djgene01/night-owl-radio/enclosure/ClockRadio_Foot_TPU_print4.stl

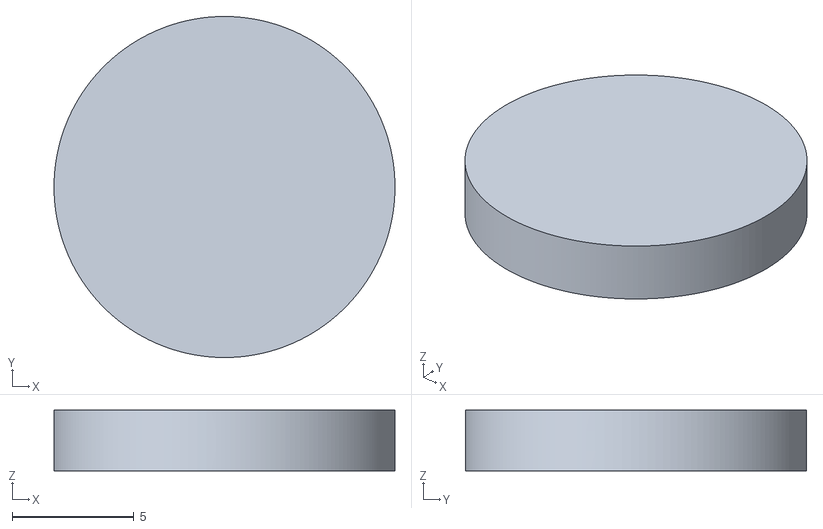
[picture p1: CAD file, 2026-11-01]
enclosure/ClockRadio_Foot_TPU_print4.stl
14.0 x 14.0 x 2.50
