djgene01/night-owl-radio/enclosure/ClockRadio_SpeakerStrap_print2.stl

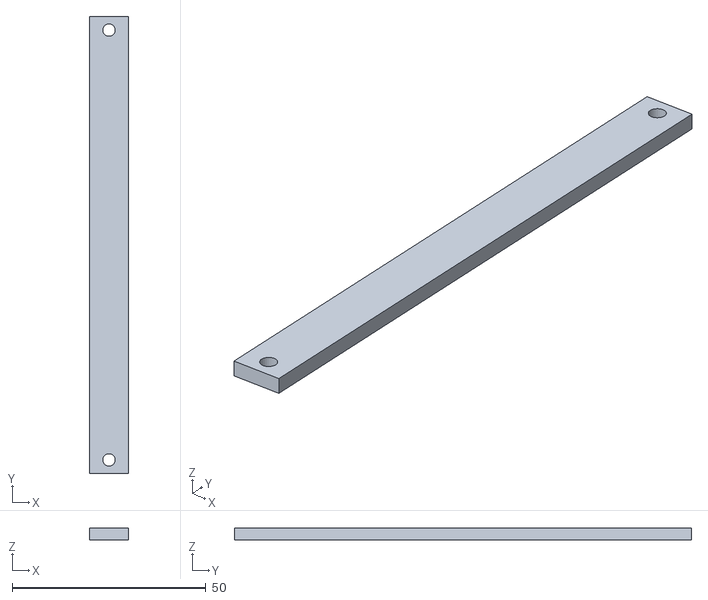
[picture p2: CAD file, 2026-11-01]
enclosure/ClockRadio_SpeakerStrap_print2.stl
10.0 x 118.0 x 3.00
