djgene01/night-owl-radio/enclosure/ClockRadio_BasePlate.stl

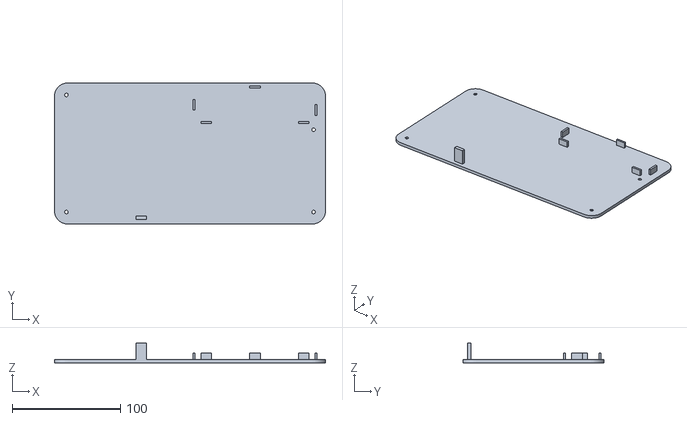
[picture p3: CAD file, 2026-11-01]
enclosure/ClockRadio_BasePlate.stl
250.0 x 130.0 x 18.0
