djgene01/night-owl-radio/enclosure/ClockRadio_Lens.stl

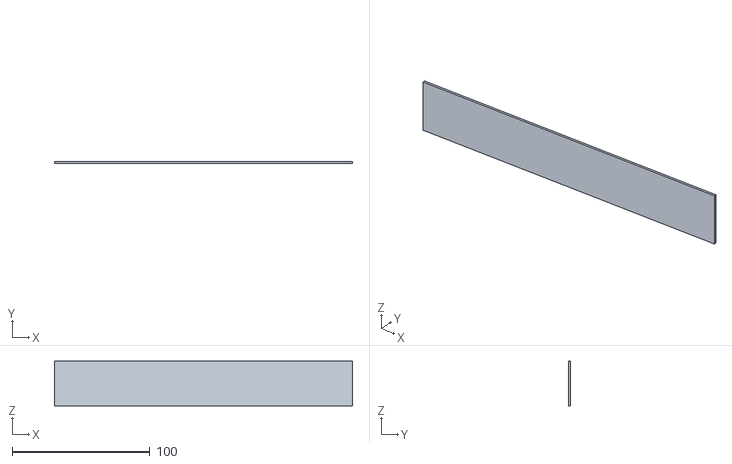
[picture p4: CAD file, 2026-11-01]
enclosure/ClockRadio_Lens.stl
216.0 x 1.50 x 32.5
