djgene01/night-owl-radio/enclosure/ClockRadio_Dial.stl

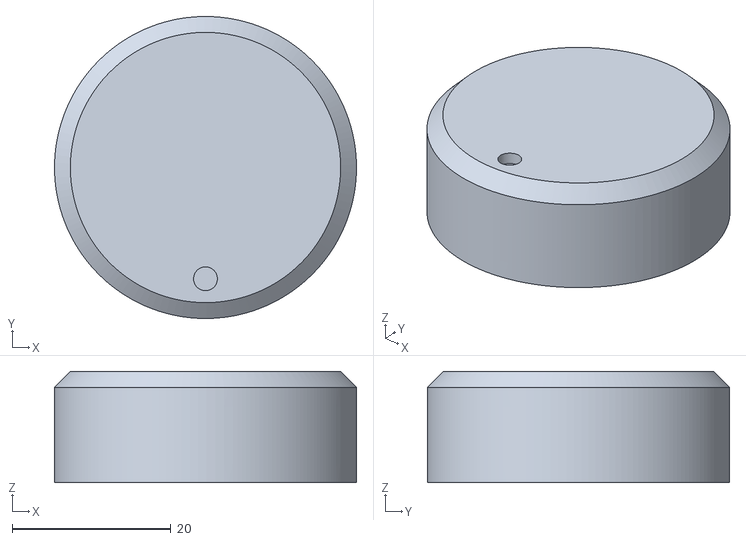
[picture p5: CAD file, 2026-11-01]
enclosure/ClockRadio_Dial.stl
38.0 x 38.0 x 14.0
