djgene01/night-owl-radio/enclosure/ClockRadio_Housing.stl

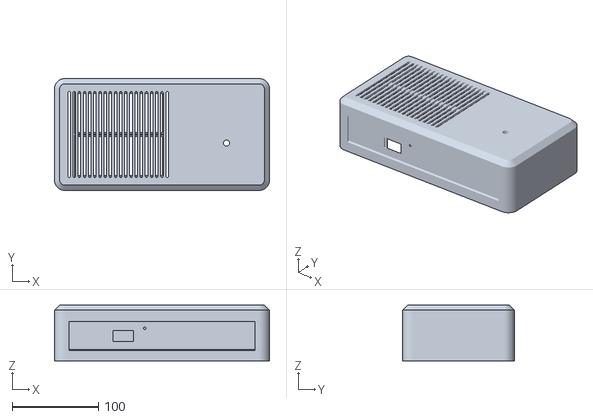
[picture p6: CAD file, 2026-11-01]
enclosure/ClockRadio_Housing.stl
250.0 x 130.0 x 65.0
