djgene01/night-owl-radio/firmware/RadioOLED/secrets.example.h

// Copy this file to secrets.h (same folder) and put your WiFi details in it.
// secrets.h is listed in .gitignore so your password never ends up on GitHub.
// The ESP32 only joins 2.4 GHz networks.
#pragma once
#define WIFI_SSID     "your-wifi-name"
#define WIFI_PASSWORD "your-wifi-password"
